Michele-Bufis/Pure_trace/(commit log)

2026-08-13 Rename # Pure-Trace — Complete Project Doc.md to Complete Project Documentation
2026-08-13 Rename Pure-Trace_documentazione.md to Documentazione completa del progetto
2026-08-18 Update analysis_engine_QRSduratio.py
    è stata sostituita def detect_rpeak con def filter_signal, def detect_rpeak, def detect r_peaks indices. Sono state aggiunte 2 funzioni qrs_duration e def extract_qrs_duration
2026-08-18 debug mode resolution now matches the device
2026-08-18 add ErrorOverlay widget for improved error handling and display
    [acquisition_screen.py, profile_dialog.py, widgets.py]
2026-08-30 refactor: replace error overlay with message overlay for unified notifications
    [acquisition_screen.py, widgets.py]
2026-08-30 style: enhance back button appearance and accessibility in session detail widget
2026-09-03 Update README and implement GPLv3 license
    - Changed license from MIT to GPLv3 in README.md and added a new LICENSE file.
    - Added a legal notice dialog in the main application window to inform users about GPLv3 terms.
    - Updated TabBar to include a button for displaying the legal notice.
    - Corrected references to documentation files in README.md for consistency.
