Michele-Bufis/Pure_trace/(notices)

Notices in the files:
README.md:
License: GPLv3
